Panther-Racing/Vehicle-Surface-Pressure-Sensor-V1/Hardware/CAN_IB_V1/Connector Drawings/ENG_CD_DT13-08PX_C.pdf

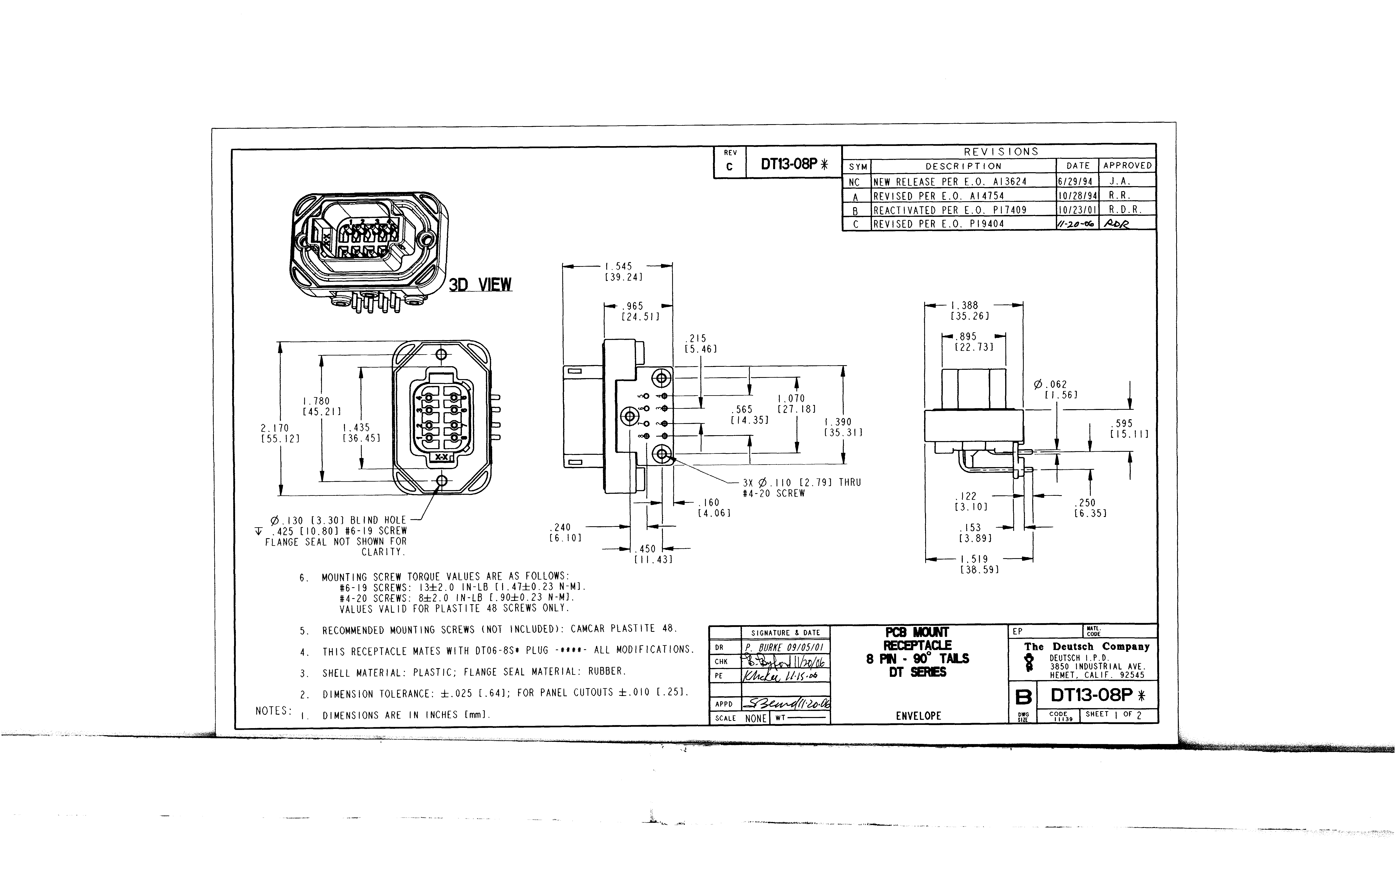
[picture p3: page 1]
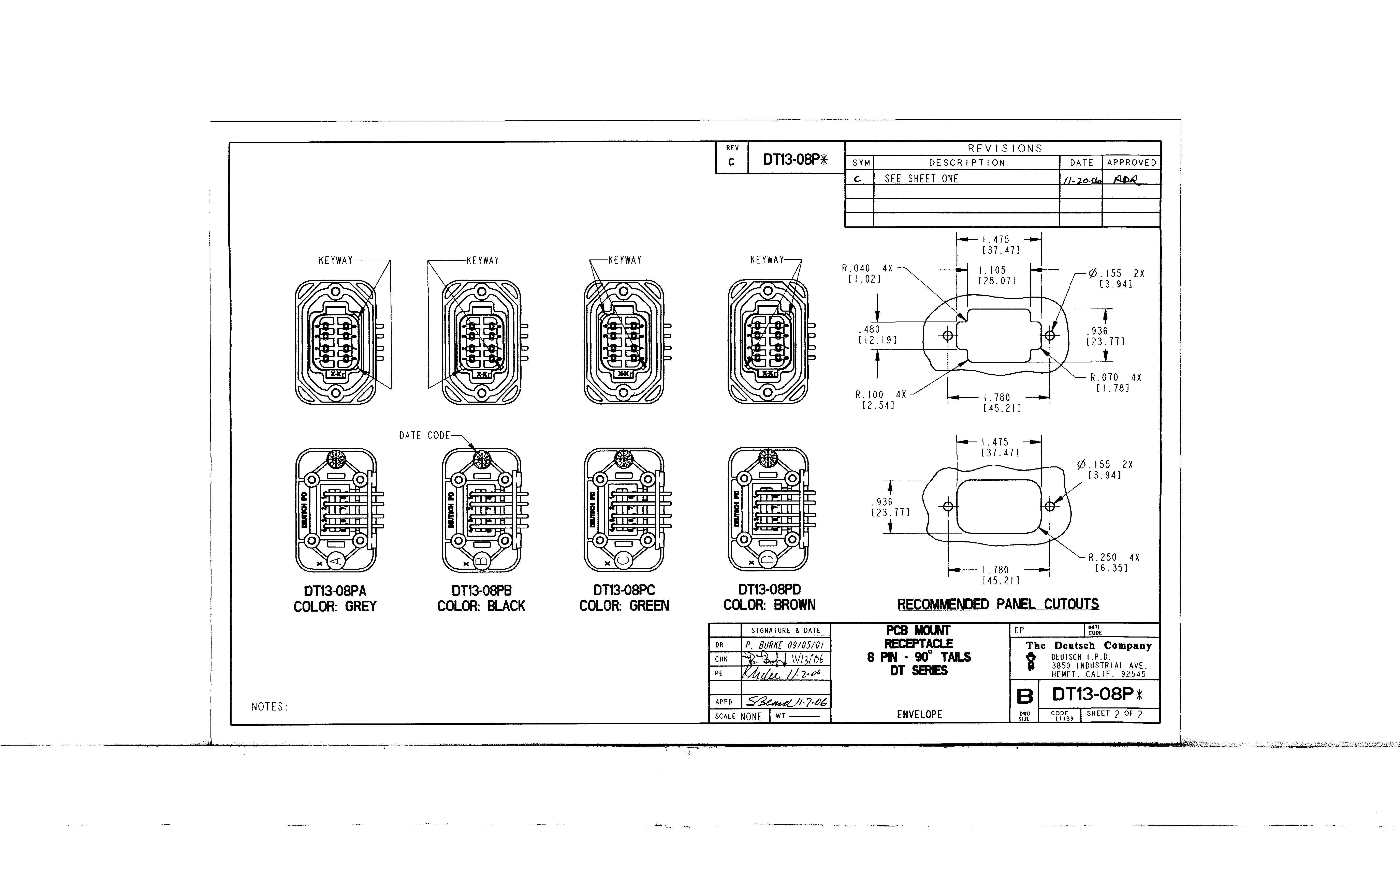
[picture p4: page 2]
