Panther-Racing/Vehicle-Surface-Pressure-Sensor-V1/Hardware/CAN_IB_V1/Connector Drawings/ENG_CD_DT13-6P_D.pdf

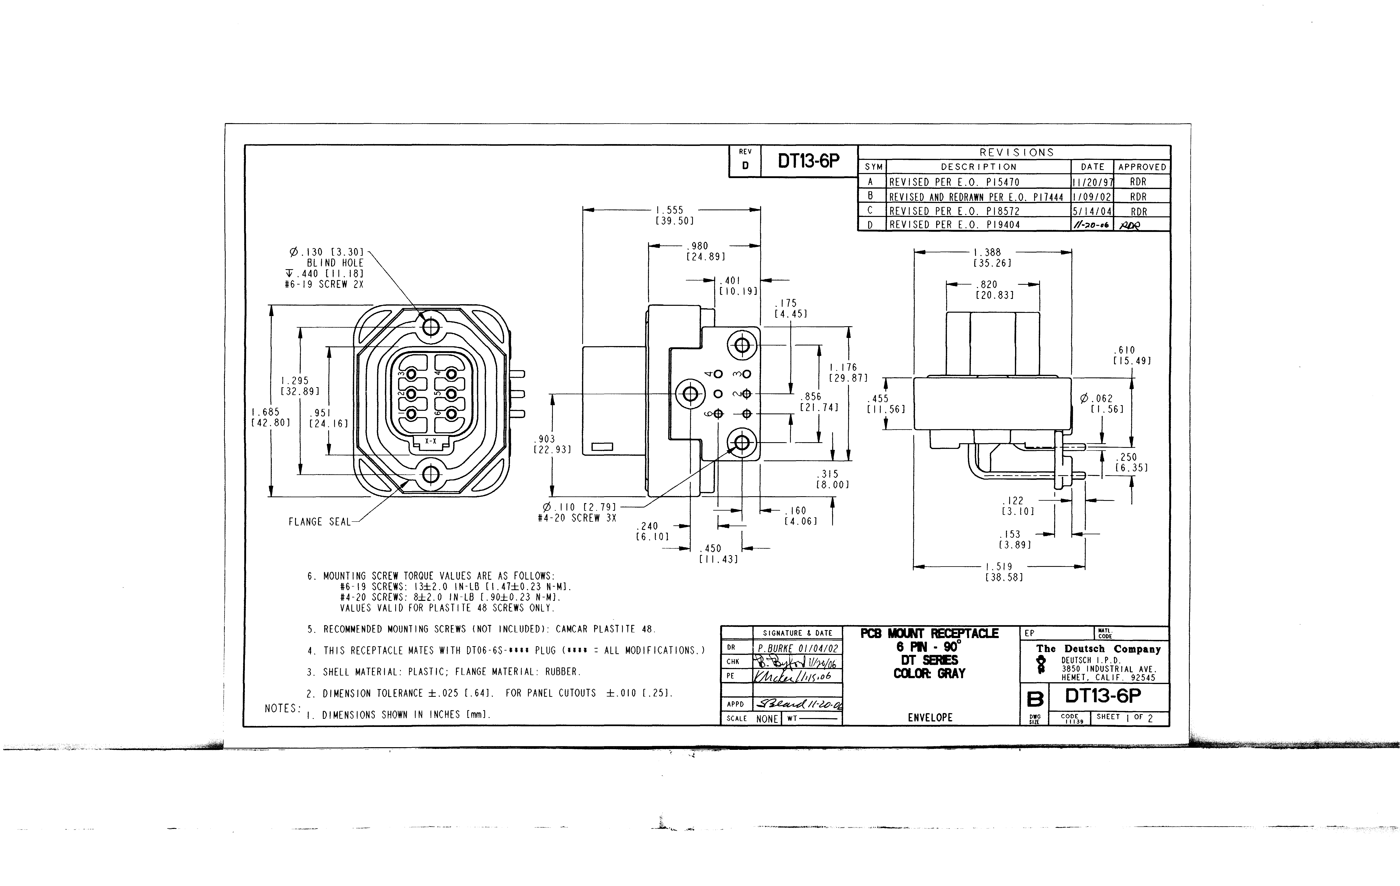
[picture p5: page 1]
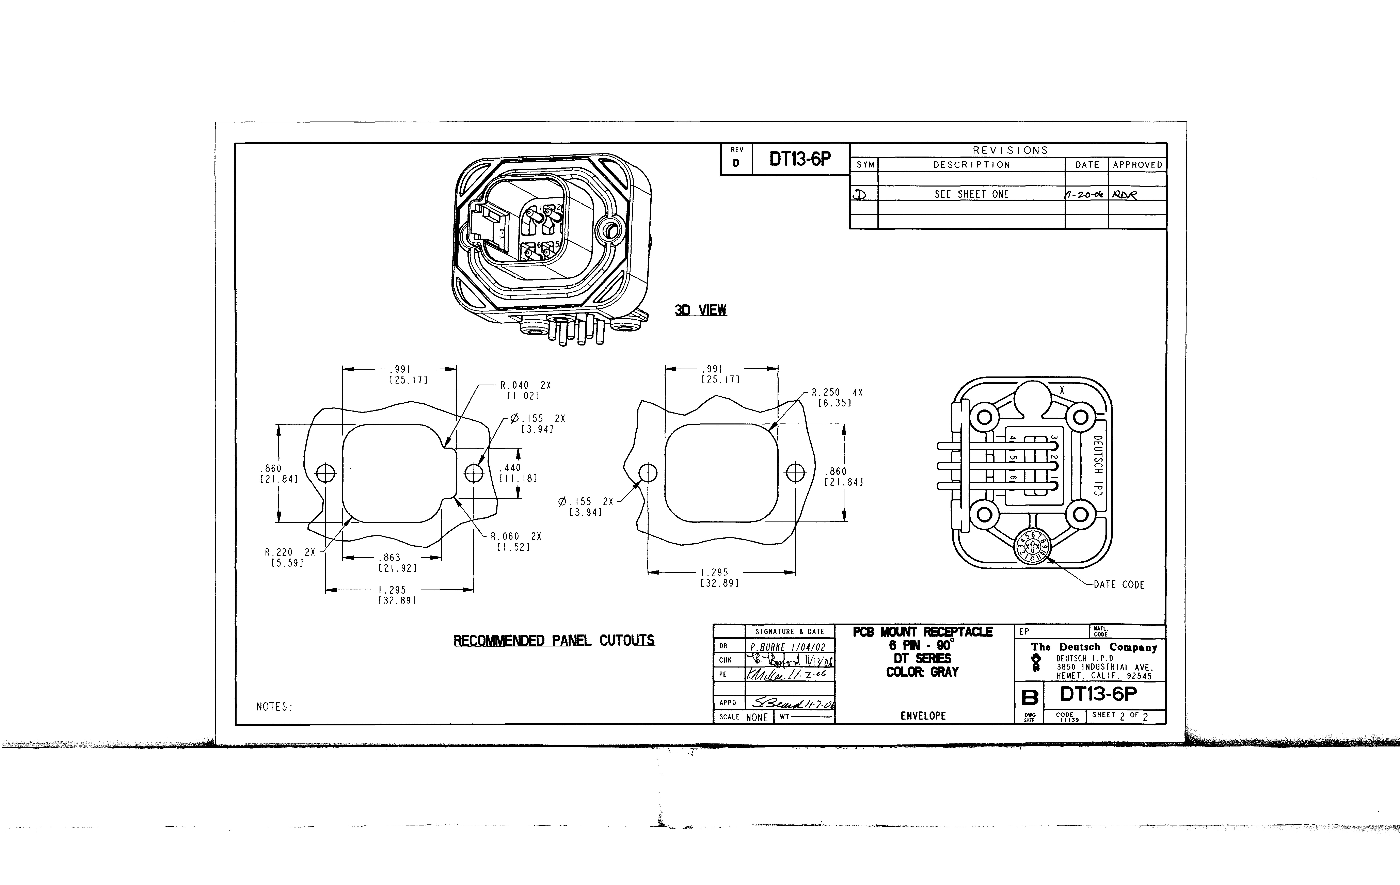
[picture p6: page 2]
