Panther-Racing/Vehicle-Surface-Pressure-Sensor-V1/Schematic PDF/CAN_IB_PDF.pdf

# Microcontroller 1 2

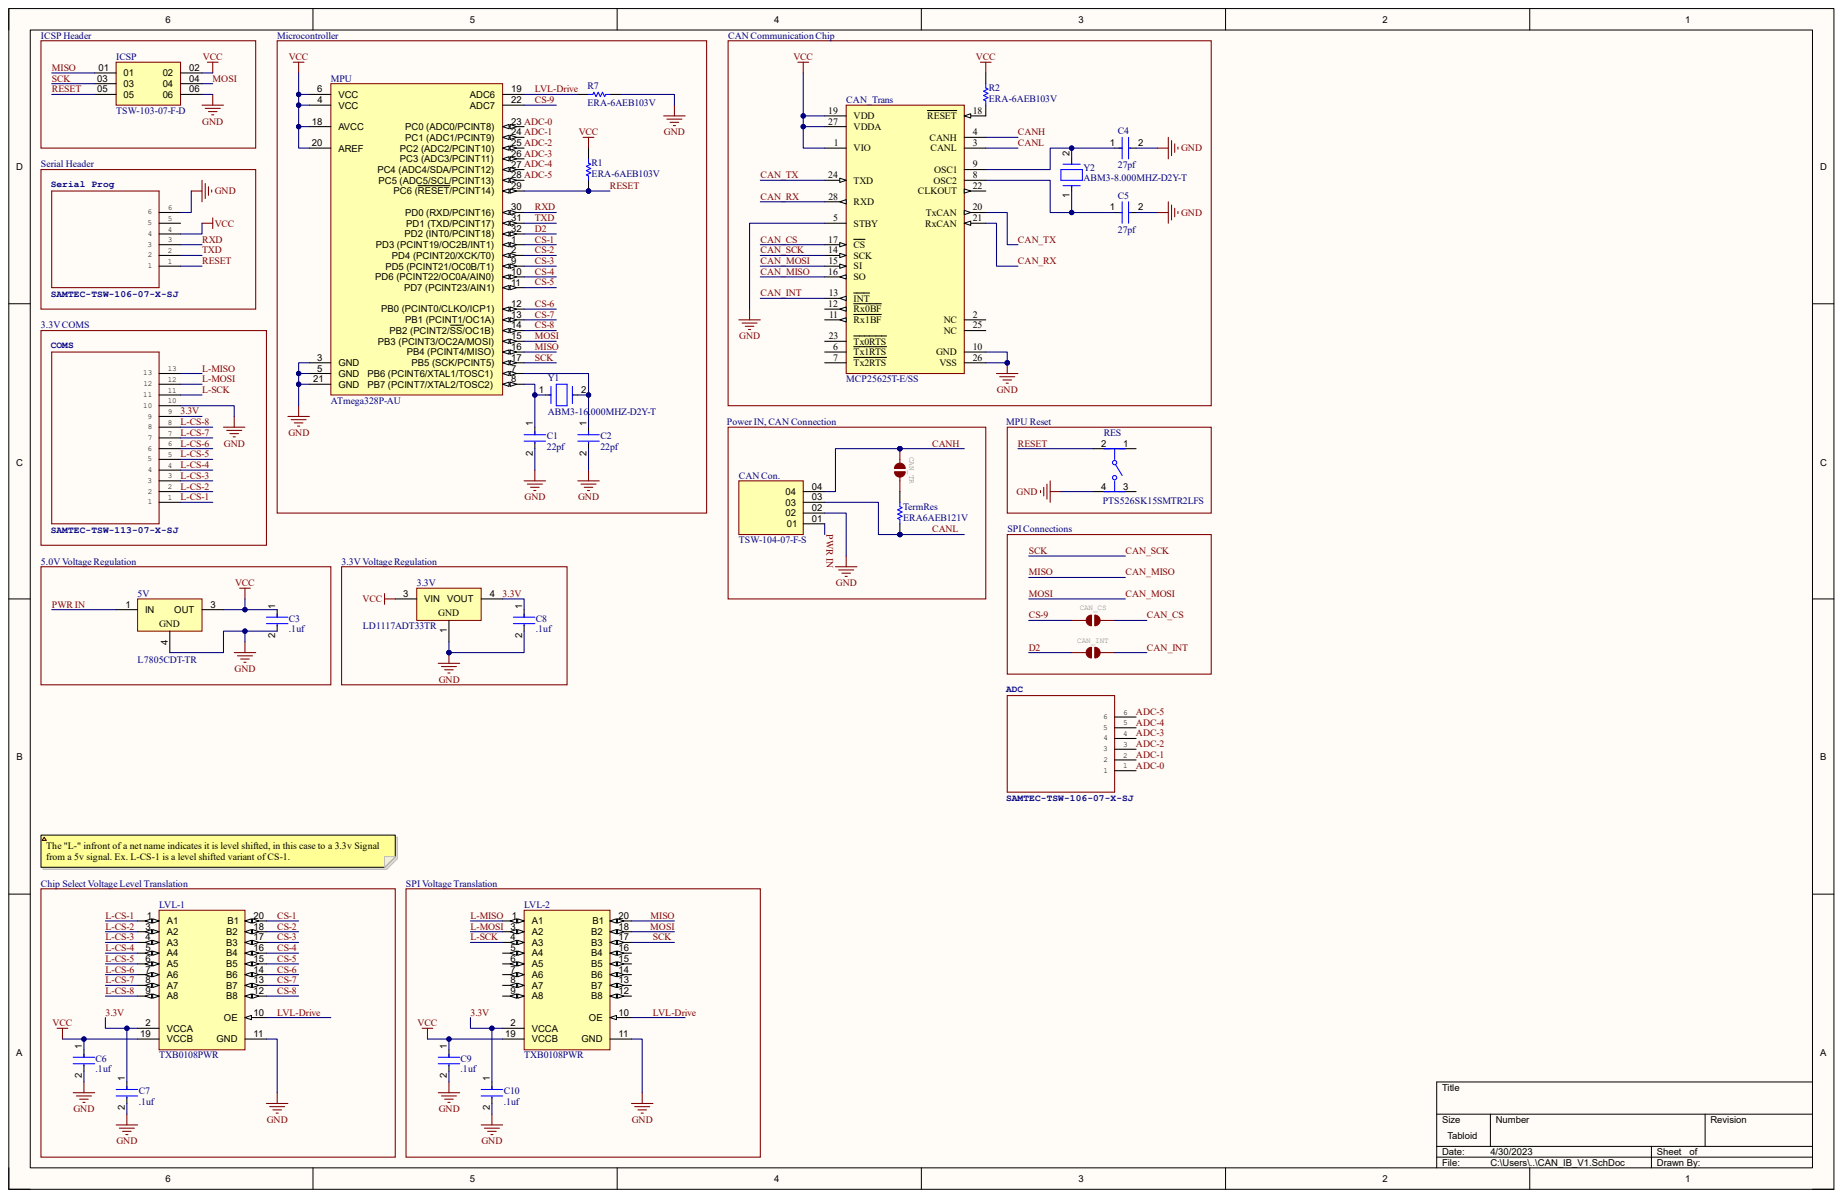
[picture p7: page 1]

Power IN, CAN Connection

The "L-" infront of a net name indicates it is level shifted, in this case to a 3.3v Signal
from a 5v signal. Ex. L-CS-1 is a level shifted variant of CS-1.

Chip Select Voltage Level Translation

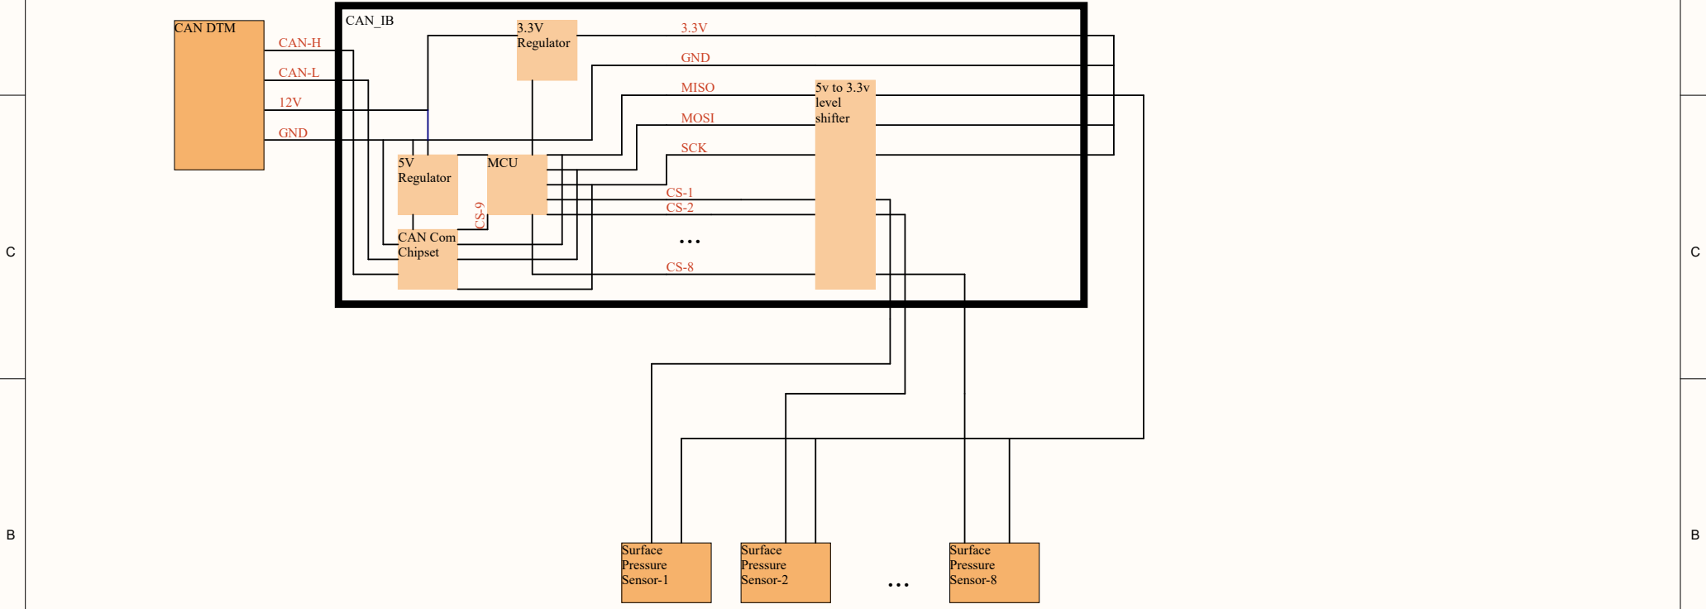
[picture p8: figure]
CAN-H; CAN-L; GND; MISO; MOSI; Surface Pressure Sensor-1; CAN_IB CAN DTM; Surface Pressure; Sensor-2; Surface Pressure Sensor-8; 5V Regulator; 3.3V Regulator; MCU; SCK; CAN Com; Chipset; 5v to 3.3v level shifter

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
## Title

Size | Number | Revision
A4
Date: | 4/30/2023 | Sheet of
File: | C:\Users\..\Interface Diagram.SchDoc | Drawn By:
