Panther-Racing/Vehicle-Surface-Pressure-Sensor-V1/(list of files, drawings)

Other design files:
Hardware/CAN_IB_V1/CAN_IB_V1.PcbDoc
Hardware/CAN_IB_V1/CAN_IB_V1.PrjPcb
Hardware/CAN_IB_V1/CAN_IB_V1.SchDoc
Hardware/CAN_IB_V1/Future-Considerations.SchDoc
Hardware/CAN_IB_V1/Interface Diagram.SchDoc
Hardware/CAN_IB_V1/Testing List.SchDoc
Hardware/SurfacePressureSensor_V1/SurfacePressureSensor_V1.PcbDoc
Hardware/SurfacePressureSensor_V1/SurfacePressureSensor_V1.PrjPcb
Hardware/SurfacePressureSensor_V1/SurfacePressureSensor_V1.SchDoc
Hardware/SurfacePressureSensor_V2/SurfacePressureSensor_V2.PcbDoc
Hardware/SurfacePressureSensor_V2/SurfacePressureSensor_V2.PrjPcb
Hardware/SurfacePressureSensor_V2/SurfacePressureSensor_V2.SchDoc
