Panther-Racing/Vehicle-Surface-Pressure-Sensor-V1/(commit log)

2023-03-22 V1 board
    [SurfacePressureSensor_V1.PcbDoc, SurfacePressureSensor_V1.PrjPcb, SurfacePressureSensor_V1.SchDoc]
2023-03-29 V1 Finalized
    [SurfacePressureSensor_V1.GBL, SurfacePressureSensor_V1.GBO, SurfacePressureSensor_V1.GBP, SurfacePressureSensor_V1.GBS, SurfacePressureSensor_V1.GTL, SurfacePressureSensor_V1.GTO, SurfacePressureSensor_V1.GTP, SurfacePressureSensor_V1.GTS]
2023-04-13 V1 fix BMP pad
    [SurfacePressureSensor_V1.GBL, SurfacePressureSensor_V1.GBO, SurfacePressureSensor_V1.GBP, SurfacePressureSensor_V1.GBS, SurfacePressureSensor_V1.GKO, SurfacePressureSensor_V1.GM1, SurfacePressureSensor_V1.GTL, SurfacePressureSensor_V1.GTO]
2023-05-24 Squashed commit of the following:
    commit f2a285b9bb323b5a4c52a2d395d991bb24ed397a
    Author: PantherRacing <Pitt.fsae@gmail.com>
    Date: Wed May 24 17:03:12 2023 -0400
    Update CAN Message.xlsx
    commit a97407815b6d194a9920cf82b60a276658cf3c3c
    Author: PantherRacing <Pitt.fsae@gmail.com>
    Date: Mon May 15 18:29:03 2023 -0400
    updated for design
    commit 50b98c4a856c20b946f70ed6492a5c71308eca6e
    Author: PantherRacing <Pitt.fsae@gmail.com>
    Date: Fri May 12 20:14:40 2023 -0400
    added bitshifting to the data reception
    ability to send data over can using 19bit integer values which means that all 8 sensors take 3 messages.
    includes a 4 bit counter value.
    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
    [CAN Message.xlsx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]
2023-06-08 updating documentaiton
    [CAN Message.xlsx]
